IlyaAyupov/injector/docs.pdf

# Инжекторная система впрыска для мотоцикла Урал

Аюпов И.Я. (https://github.com/IlyaAyupov)

лето 2020

1

## 1 Металл

Установка воздушной заслонки с датчиком положения дроссельной заслонки и регулятором холостого хода (от ВАЗ 2110).

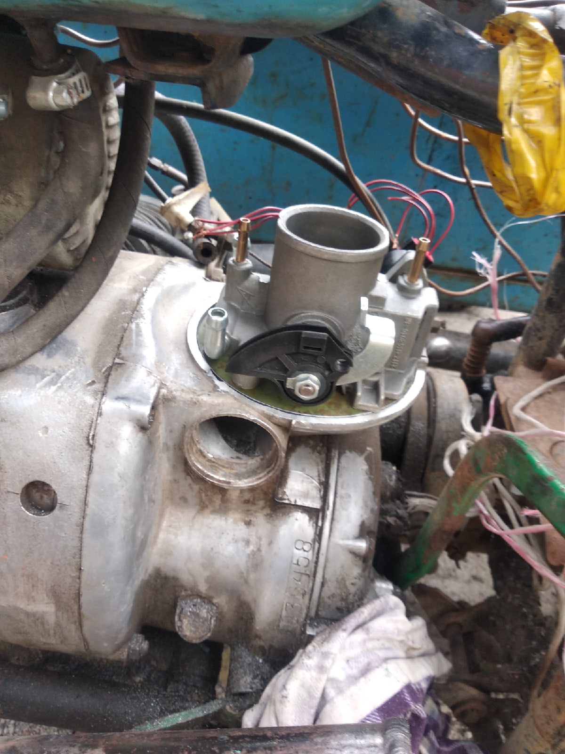
[picture p1: figure]

2

Изготовление посадочного места для форсунок.

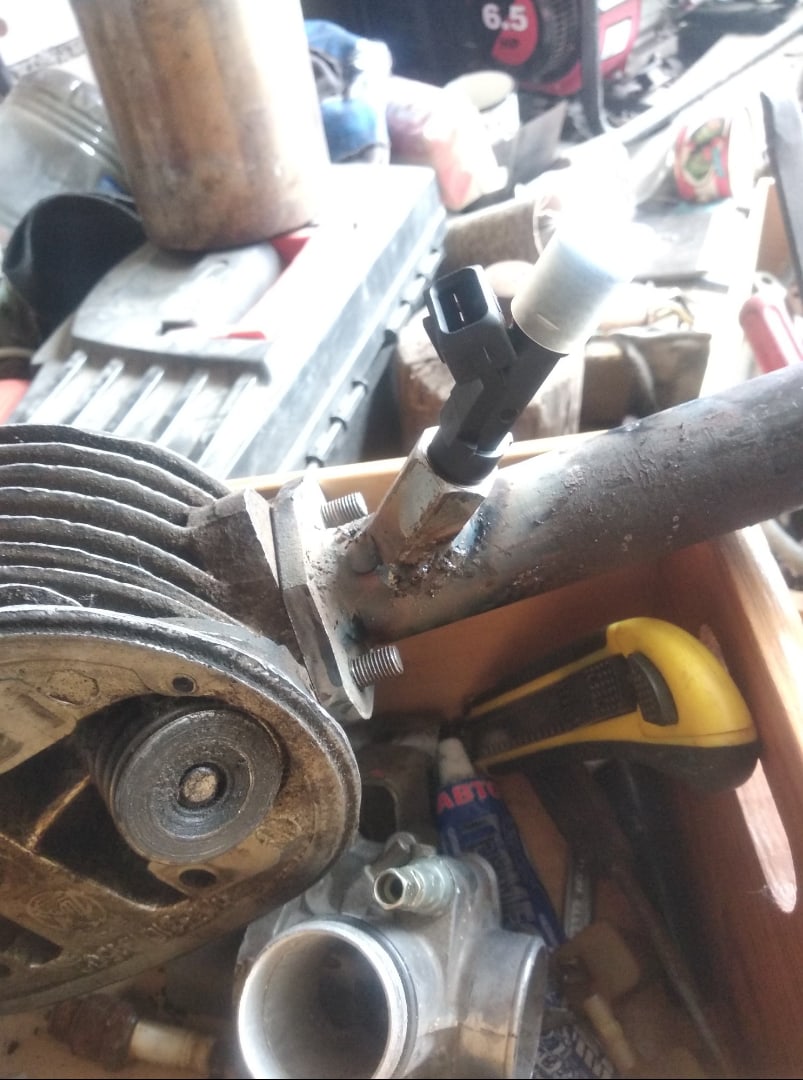
[picture p2: figure]

3

Изготовление и установка впускной системы.

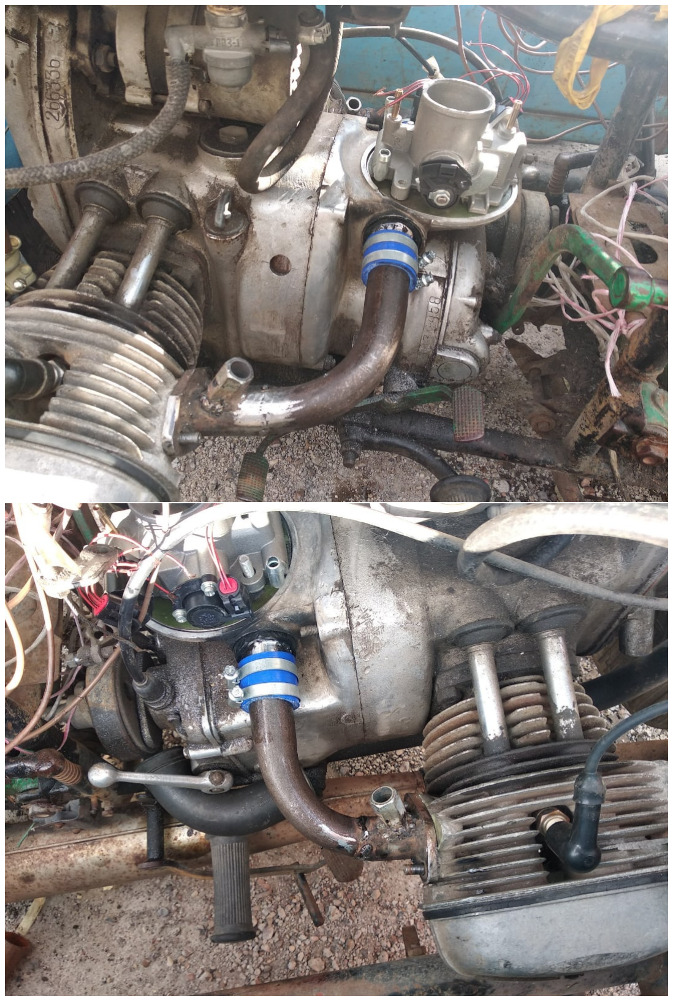
[picture p3: figure]

4

Сборка топливной системы (регулятор давления топлива и топливный насос).

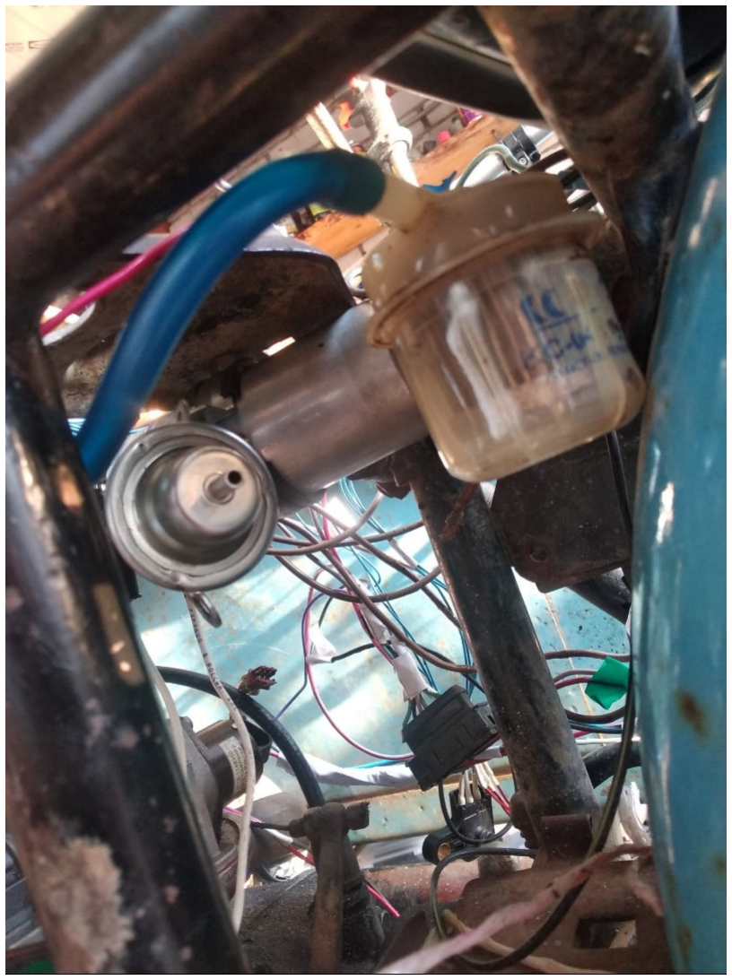
[picture p4: figure]

5

Изготовление и установка задающей шторки.

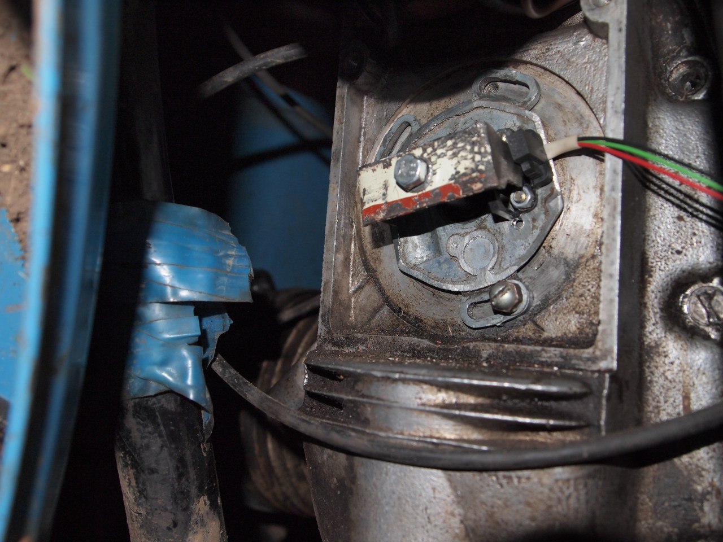
[picture p5: figure]

## 2 Блок управления

Блок управления основан на микроконтроллере STM32F103C8T6, который обрабатывает данные с аналоговых датчиков (датчик абсолютного давления, датчик положения дроссельной заслонки, датчик напряжения бортовой сети) и цифрового датчика положения коленчатого вала.
ЭБУ осуществляет управление форсунками, зажиганием и регулятором холостого хода.

## 3 Результаты

По результатам пробных выездов было замечено отсутствие провалов при резком открытии газа, улучшение динамики, увеличение крутящего момента двигателя и улучшение стабильности работы и запуска двигателя.

6
