IlyaAyupov/injector/hardware/PCB.pdf

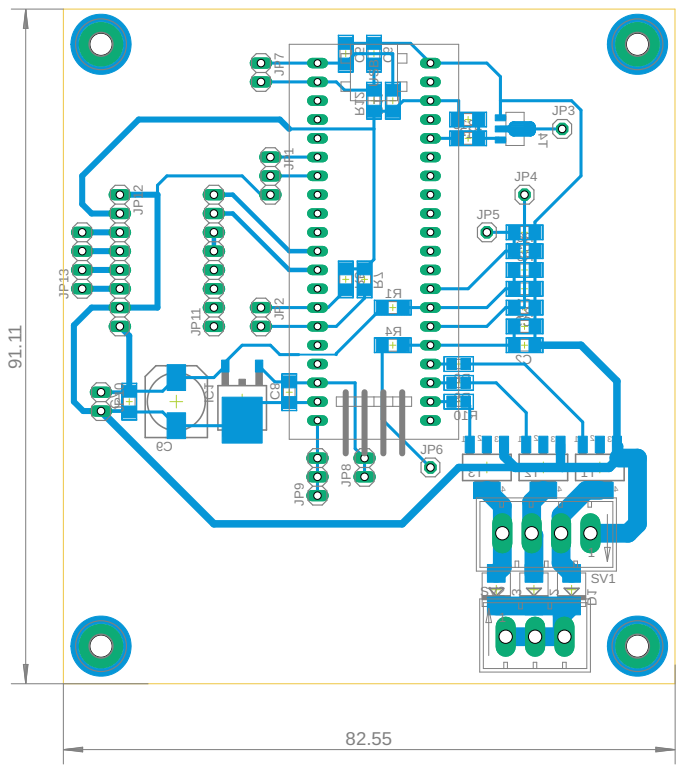
[picture p6: page 1]
