IlyaAyupov/injector/hardware/schematic.pdf

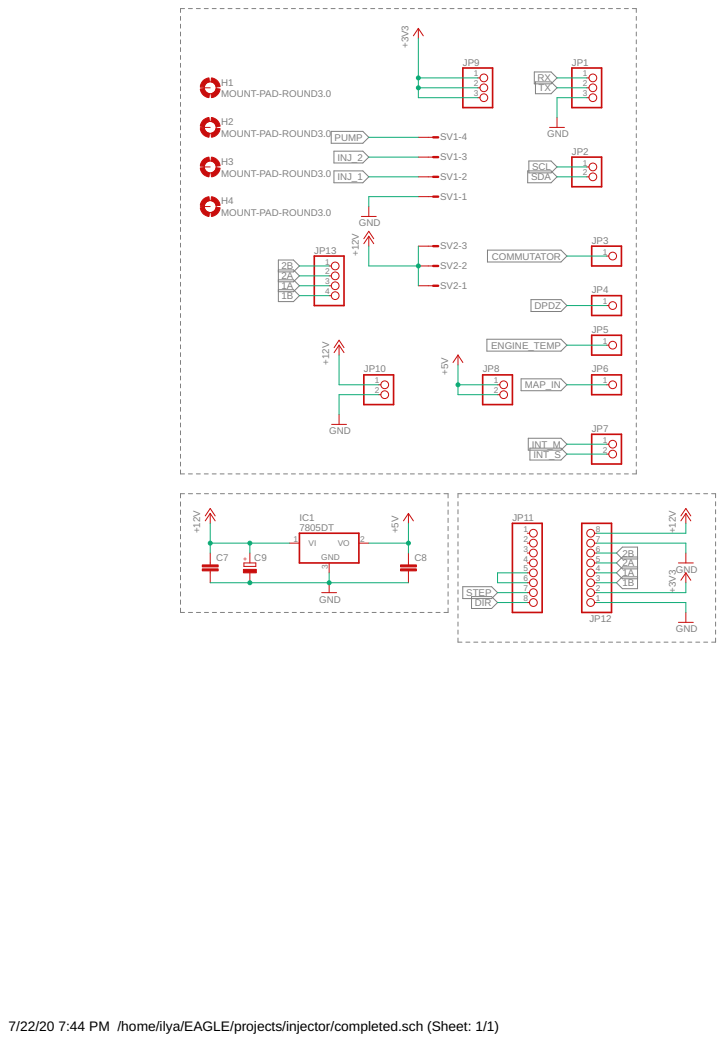
[picture p7: page 1]

7/22/20 7:44 PM /home/ilya/EAGLE/projects/injector/completed.sch (Sheet: 1/1)

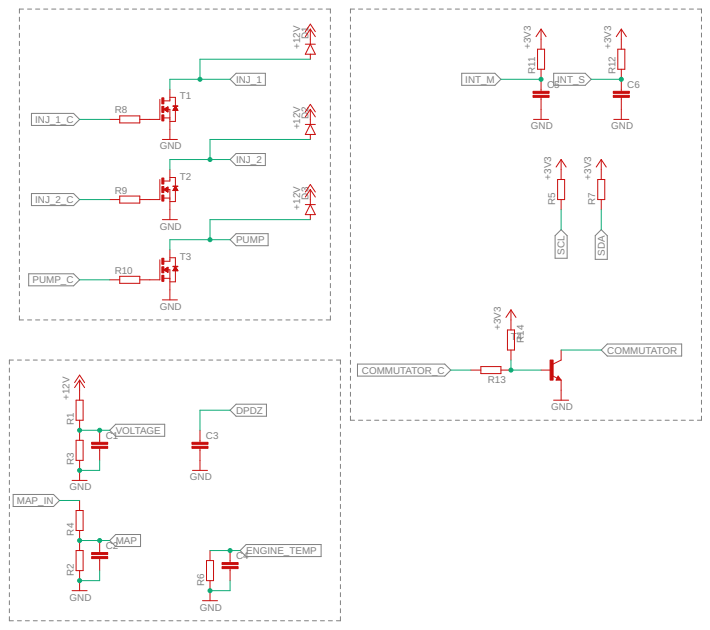
[picture p8: page 2]

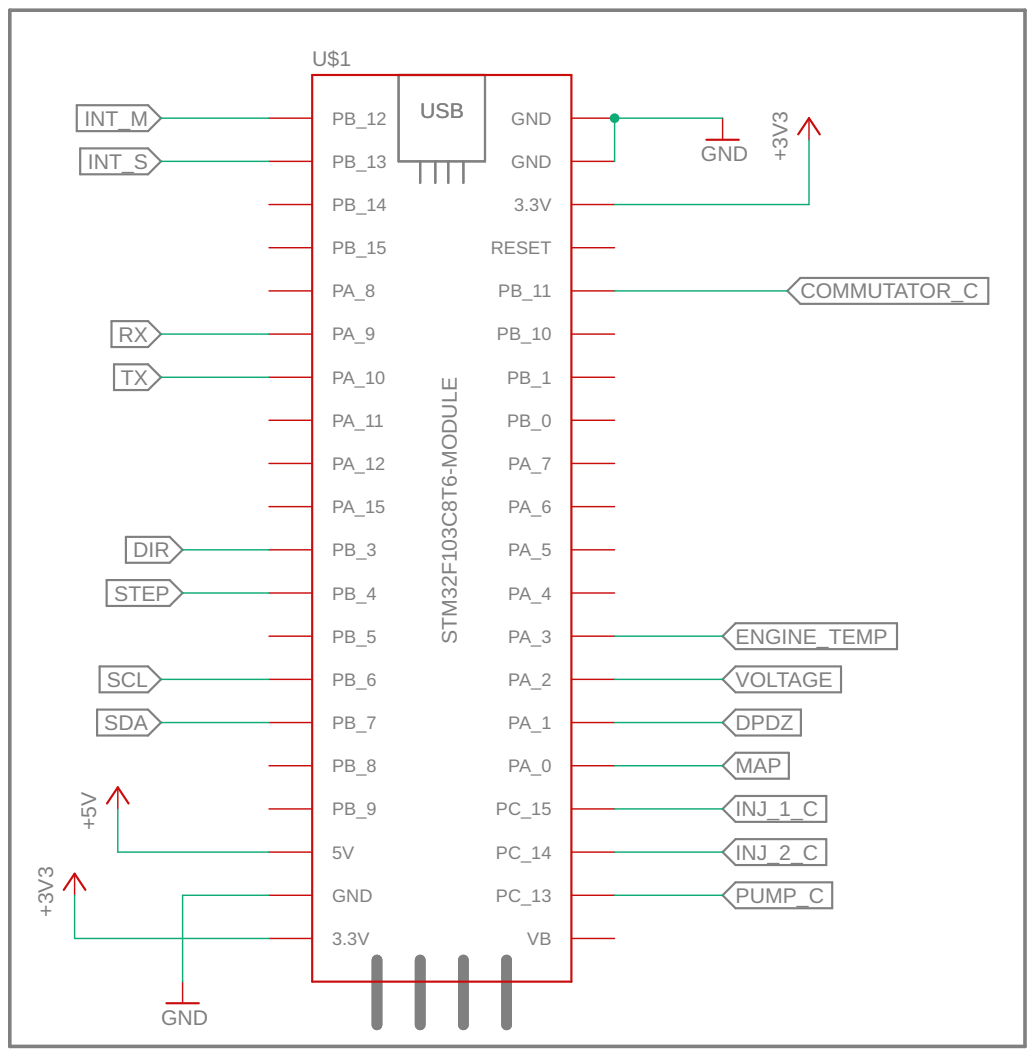
[picture p9: page 3]
