IlyaAyupov/injector/hardware/control_board.brd

## EAGLE design hardware/control_board.brd (2020-09-04)

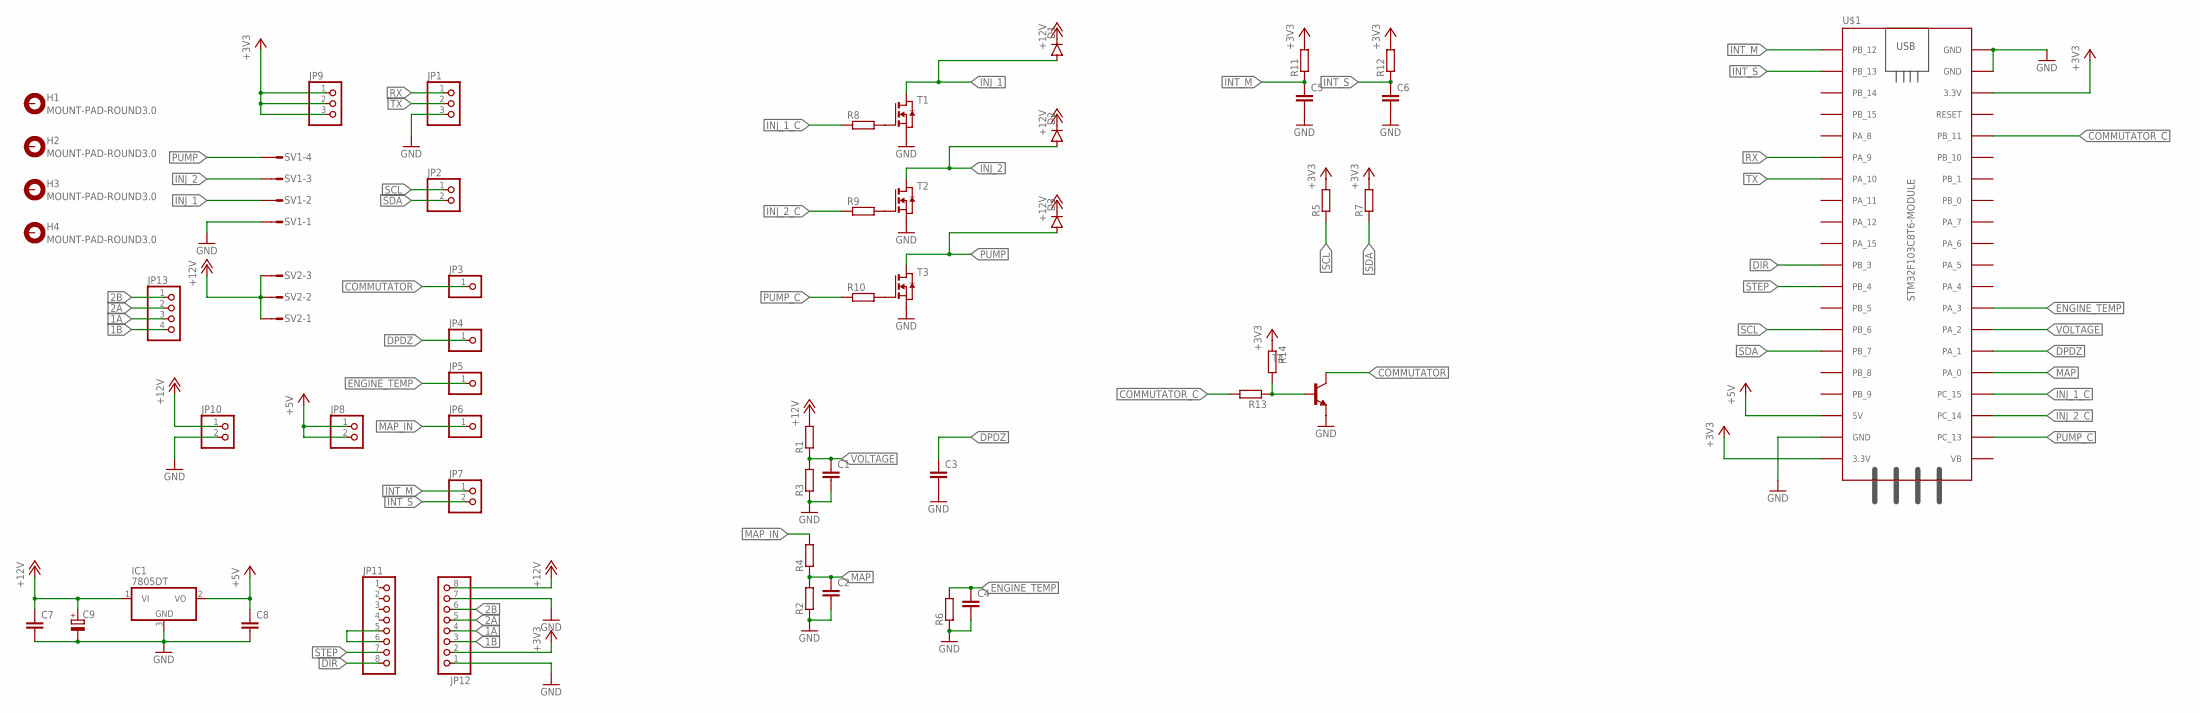
[picture p10: schematic control_board.sch]

Parts:
C1, C2, C3, C4, C5, C6, C7, C8: C-EUC1206; C1206
C9: CPOL-EU140CLH-0810; 140CLH-0810
D1, D2, D3: DIODE-SMB; SMB
H1, H2, H3, H4: MOUNT-PAD-ROUND3.0; 3,0-PAD
IC1: 7805DT; TO252
JP1, JP9: PINHD-1X3; 1X03
JP2, JP7, JP8, JP10: PINHD-1X2; 1X02
JP3, JP4, JP5, JP6: PINHD-1X1; 1X01
JP11, JP12: PINHD-1X8; 1X08
JP13: PINHD-1X4; 1X04
R1, R2, R3, R4, R5, R6, R7, R11, R12, R13, R14: R-EU_R1206; R1206
R8, R9, R10: R-EU_R0805; R0805
SV1: MT6-4
SV2: MT6-3
T1, T2, T3: NMOSSOT223; SOT223
T4: BCX54-NPN-SOT89-BCE; SOT89-BCE
U$1: STM32F103C8T6-MODULE

Connections:
1A: JP12.4, JP13.3
1B: JP12.3, JP13.4
2A: JP12.5, JP13.2
2B: JP12.6, JP13.1
+3V3: JP9.1, JP9.2, JP9.3, JP12.2, R5.2, R7.2, R11.2, R12.2, R14.1, U$1.3.3V_1 (3.3V), U$1.3.3V_2 (3.3V)
+5V: C8.1, IC1.2 (VO), JP8.1, JP8.2, U$1.5V
+12V: C7.1, C9.+, D1.C, D2.C, D3.C, IC1.1 (VI), JP10.1, JP12.8, R1.2, SV2.1, SV2.2, SV2.3
COMMUTATOR: JP3.1, T4.C
COMMUTATOR_C: R13.2, U$1.PB_11
DIR: JP11.8, U$1.PB_3
DPDZ: C3.1, JP4.1, U$1.PA_1
ENGINE_TEMP: C4.1, JP5.1, R6.2, U$1.PA_3
GND: C1.2, C2.2, C3.2, C4.2, C5.2, C6.2, C7.2, C8.2, C9.-, IC1.3 (GND), JP1.3, JP10.2, JP12.1, JP12.7, R2.1, R3.1, R6.1, SV1.1, T1.3 (S), T2.3 (S), T3.3 (S), T4.E, U$1.GND_1 (GND), U$1.GND_2 (GND), U$1.GND_3 (GND)
INJ_1: D1.A, SV1.2, T1.2 (D), T1.4 (D)
INJ_1_C: R8.1, U$1.PC_15
INJ_2: D2.A, SV1.3, T2.2 (D), T2.4 (D)
INJ_2_C: R9.1, U$1.PC_14
INT_M: C5.1, JP7.1, R11.1, U$1.PB_12
INT_S: C6.1, JP7.2, R12.1, U$1.PB_13
MAP: C2.1, R2.2, R4.1, U$1.PA_0
MAP_IN: JP6.1, R4.2
unnamed: JP11.5, JP11.6
unnamed: R13.1, R14.2, T4.B
unnamed: R8.2, T1.1 (G)
unnamed: R9.2, T2.1 (G)
unnamed: R10.2, T3.1 (G)
PUMP: D3.A, SV1.4, T3.2 (D), T3.4 (D)
PUMP_C: R10.1, U$1.PC_13
RX: JP1.1, U$1.PA_9
SCL: JP2.1, R5.1, U$1.PB_6
SDA: JP2.2, R7.1, U$1.PB_7
STEP: JP11.7, U$1.PB_4
TX: JP1.2, U$1.PA_10
VOLTAGE: C1.1, R1.1, R3.2, U$1.PA_2

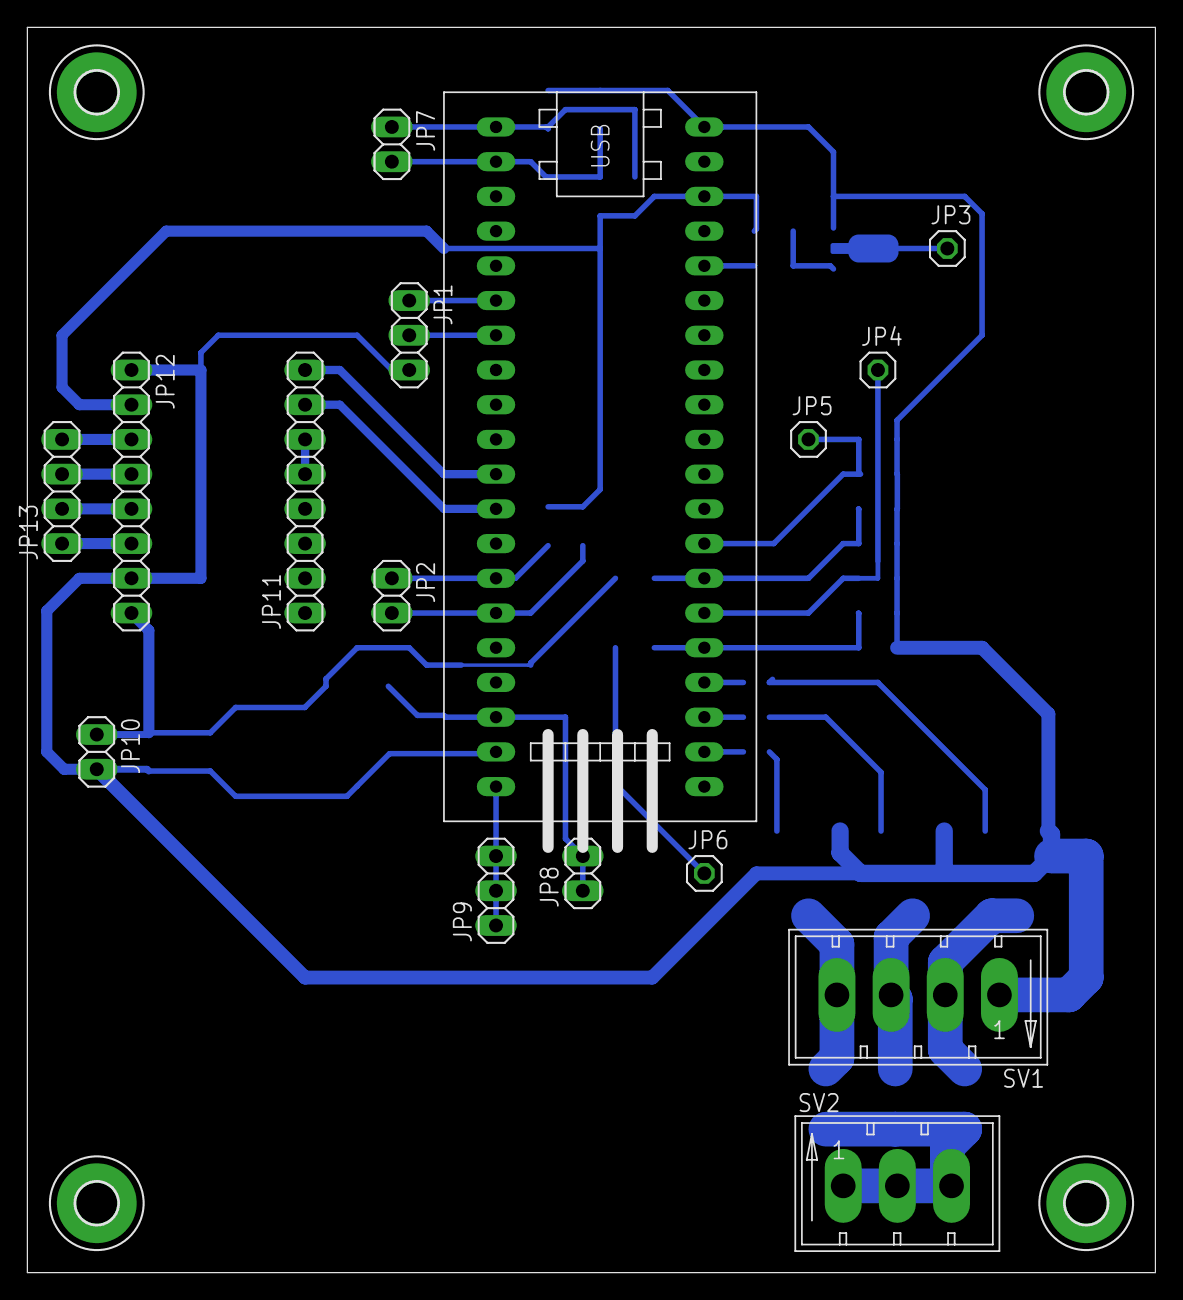
[picture p11: board control_board.brd from above]

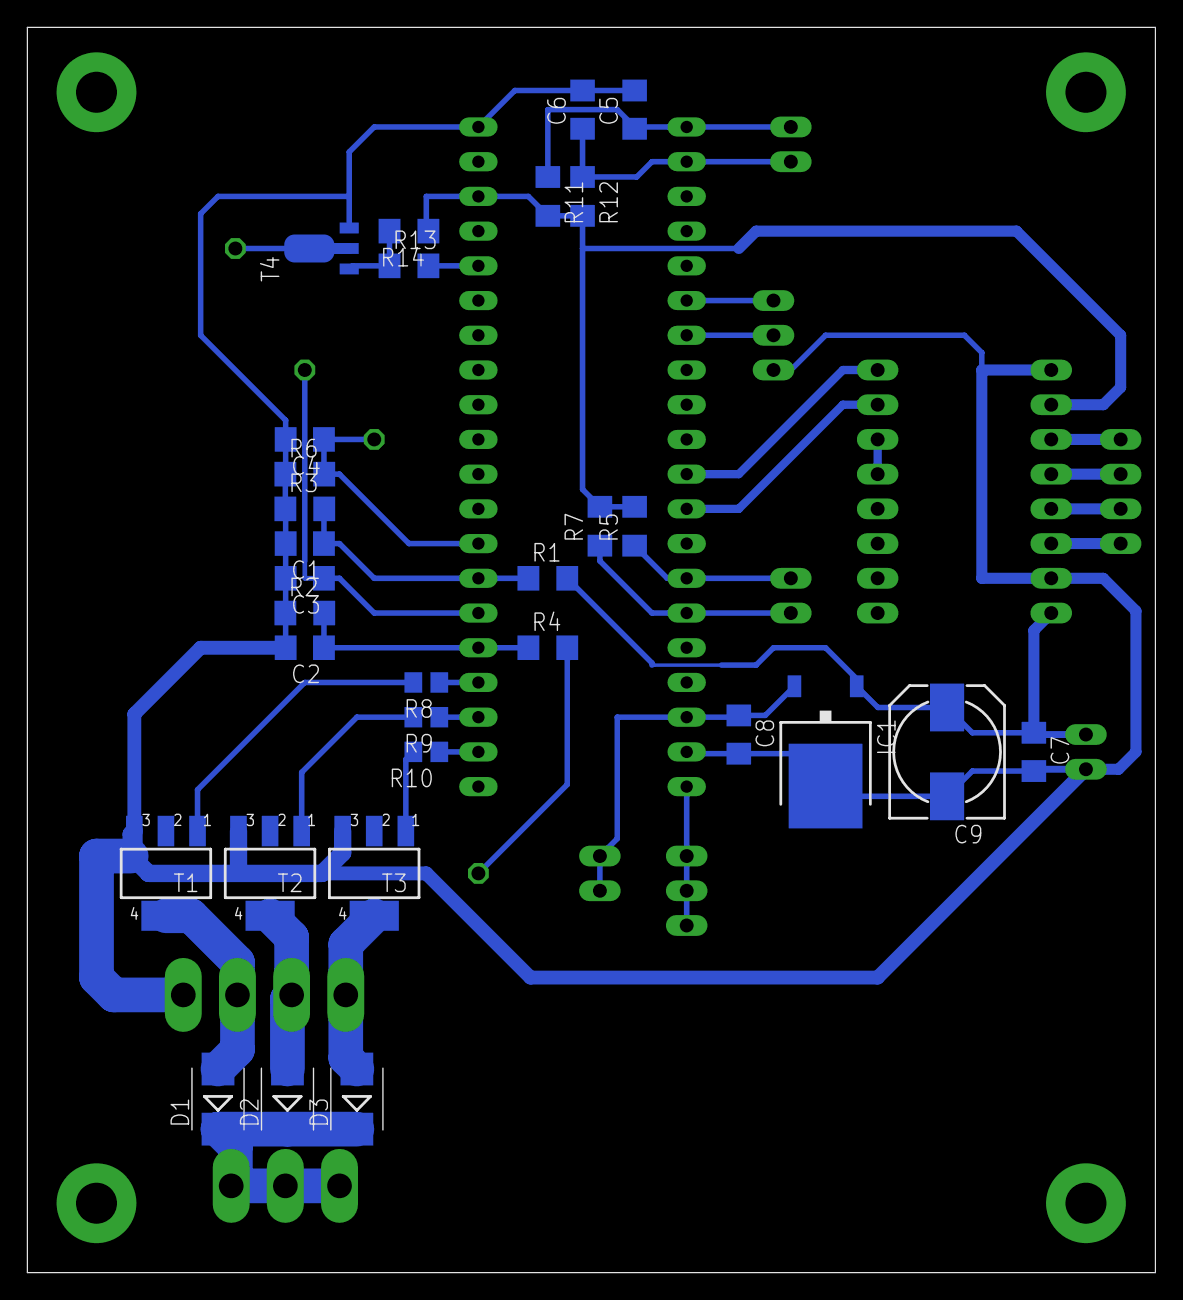
[picture p12: board control_board.brd from below]

Board: 2 copper layers, 82.5 x 91.1 mm, 51 parts (31 on the bottom side), 34 nets.
