IlyaAyupov/injector/code/stm/Src/main.c

#include "main.h"
#define DPDZ_MIN 447
#define DPDZ_MAX 3500
#define THROTTLE_LIMIT 3
ADC_HandleTypeDef hadc1;
DMA_HandleTypeDef hdma_adc1;

TIM_HandleTypeDef htim3;

UART_HandleTypeDef huart1;

#define RXX_DELAY 2

void SystemClock_Config(void);
static void MX_GPIO_Init(void);
static void MX_DMA_Init(void);
static void MX_ADC1_Init(void);
static void MX_TIM3_Init(void);
static void MX_USART1_UART_Init(void);
uint8_t injLag[]={11,11,11,11,11,11,11,11,11,11,11,9,8,7,6,5};
uint16_t time=0;
uint16_t getLag(float voltage){
	uint8_t l=(int)voltage;
	return injLag[l]+(injLag[l+1]-injLag[l])*(voltage-l);
}
void calculation(){
	if(engine.temporary.timing==0)engine.RPM=0;
	else engine.RPM=(6000000*15)/(engine.temporary.timing*18);
	engine.voltage=(adcData.voltage*537.9)/135168.0;
	engine.pressure=37500.0+30.4138*adcData.map;
	engine.injTime=engine.RPM>400?((uint16_t)(6.51*engine.pressure*engine.Kc/(engine.temperature*engine.AFR))+getLag(engine.voltage)):110;
	engine.throttle=(adcData.DPDZ-DPDZ_MIN)*100.0/(DPDZ_MAX-DPDZ_MIN);
}
void move(uint8_t step,uint8_t dir){
	//engine.RXX+=dir?(-step):step;

	HAL_GPIO_WritePin(GPIOB, GPIO_PIN_3, dir);
	for(int i=0;i<step;i++){
		  HAL_GPIO_WritePin(GPIOB, GPIO_PIN_4, 1);
		  HAL_Delay(RXX_DELAY);

		  HAL_GPIO_WritePin(GPIOB, GPIO_PIN_4, 0);
		  HAL_Delay(RXX_DELAY);
	  }
}
void init(){
	engine.Kc=0.18;
	engine.AFR=14.7;
	engine.temperature=298;
	engine.RPM_XX=500;
}

int main(void)
{
  HAL_Init();
  SystemClock_Config();
  MX_GPIO_Init();
  MX_DMA_Init();
  MX_ADC1_Init();
  MX_TIM3_Init();
  MX_USART1_UART_Init();
  HAL_TIM_Base_Start_IT(&htim3);
  char buffer[100];
  HAL_GPIO_WritePin(GPIOC, GPIO_PIN_14,0);
  HAL_GPIO_WritePin(GPIOC, GPIO_PIN_15,0);
  HAL_GPIO_WritePin(GPIOC, GPIO_PIN_13,1);
  HAL_GPIO_WritePin(GPIOB, GPIO_PIN_11,0);
  RCC->APB1ENR |= RCC_APB1ENR_TIM2EN;
  HAL_ADC_Start_DMA(&hadc1, (uint32_t*)&adcData, 3);
  HAL_Delay(10);
  init();
  while (1)
  {
    if(engine.RPM==0){
		  engine.Kc=0.3;
		  time=0;
	  }
	  time++;
	  if(time>50){
		  engine.Kc=0.2;
	  }
	  calculation();
	  move(abs(engine.RPM-engine.RPM_XX)/100,engine.RPM>700?1:0);
	  sprintf(buffer,"A\n\r%f\n\r%f\n\r%d\n\r%d\n\r%f\n\r%d\n\r",engine.pressure,engine.voltage,engine.RPM,engine.injTime,engine.throttle,engine.RXX);
	  HAL_ADC_Start_DMA(&hadc1, (uint32_t*)&adcData, 3);
	  HAL_UART_Transmit(&huart1,buffer,strlen(buffer),1000);
	  HAL_Delay(200);

  }
}
void SystemClock_Config(void)
{
  RCC_OscInitTypeDef RCC_OscInitStruct = {0};
  RCC_ClkInitTypeDef RCC_ClkInitStruct = {0};
  RCC_PeriphCLKInitTypeDef PeriphClkInit = {0};
  RCC_OscInitStruct.OscillatorType = RCC_OSCILLATORTYPE_HSE;
  RCC_OscInitStruct.HSEState = RCC_HSE_ON;
  RCC_OscInitStruct.HSEPredivValue = RCC_HSE_PREDIV_DIV1;
  RCC_OscInitStruct.HSIState = RCC_HSI_ON;
  RCC_OscInitStruct.PLL.PLLState = RCC_PLL_ON;
  RCC_OscInitStruct.PLL.PLLSource = RCC_PLLSOURCE_HSE;
  RCC_OscInitStruct.PLL.PLLMUL = RCC_PLL_MUL9;
  if (HAL_RCC_OscConfig(&RCC_OscInitStruct) != HAL_OK)
  {
    Error_Handler();
  }
  RCC_ClkInitStruct.ClockType = RCC_CLOCKTYPE_HCLK|RCC_CLOCKTYPE_SYSCLK
                              |RCC_CLOCKTYPE_PCLK1|RCC_CLOCKTYPE_PCLK2;
  RCC_ClkInitStruct.SYSCLKSource = RCC_SYSCLKSOURCE_PLLCLK;
  RCC_ClkInitStruct.AHBCLKDivider = RCC_SYSCLK_DIV1;
  RCC_ClkInitStruct.APB1CLKDivider = RCC_HCLK_DIV2;
  RCC_ClkInitStruct.APB2CLKDivider = RCC_HCLK_DIV1;

  if (HAL_RCC_ClockConfig(&RCC_ClkInitStruct, FLASH_LATENCY_2) != HAL_OK)
  {
    Error_Handler();
  }
  PeriphClkInit.PeriphClockSelection = RCC_PERIPHCLK_ADC;
  PeriphClkInit.AdcClockSelection = RCC_ADCPCLK2_DIV6;
  if (HAL_RCCEx_PeriphCLKConfig(&PeriphClkInit) != HAL_OK)
  {
    Error_Handler();
  }
}
static void MX_ADC1_Init(void)
{

  ADC_ChannelConfTypeDef sConfig = {0};
  hadc1.Instance = ADC1;
  hadc1.Init.ScanConvMode = ADC_SCAN_ENABLE;
  hadc1.Init.ContinuousConvMode = DISABLE;
  hadc1.Init.DiscontinuousConvMode = DISABLE;
  hadc1.Init.ExternalTrigConv = ADC_SOFTWARE_START;
  hadc1.Init.DataAlign = ADC_DATAALIGN_RIGHT;
  hadc1.Init.NbrOfConversion = 3;
  if (HAL_ADC_Init(&hadc1) != HAL_OK)
  {
    Error_Handler();
  }
  sConfig.Channel = ADC_CHANNEL_0;
  sConfig.Rank = ADC_REGULAR_RANK_1;
  sConfig.SamplingTime = ADC_SAMPLETIME_1CYCLE_5;
  if (HAL_ADC_ConfigChannel(&hadc1, &sConfig) != HAL_OK)
  {
    Error_Handler();
  }
  sConfig.Channel = ADC_CHANNEL_1;
  sConfig.Rank = ADC_REGULAR_RANK_2;
  if (HAL_ADC_ConfigChannel(&hadc1, &sConfig) != HAL_OK)
  {
    Error_Handler();
  }
  sConfig.Channel = ADC_CHANNEL_2;
  sConfig.Rank = ADC_REGULAR_RANK_3;
  if (HAL_ADC_ConfigChannel(&hadc1, &sConfig) != HAL_OK)
  {
    Error_Handler();
  }

}

static void MX_TIM3_Init(void)
{
  TIM_ClockConfigTypeDef sClockSourceConfig = {0};
  TIM_MasterConfigTypeDef sMasterConfig = {0};
  htim3.Instance = TIM3;
  htim3.Init.Prescaler = 719;
  htim3.Init.CounterMode = TIM_COUNTERMODE_UP;
  htim3.Init.Period = 49999;
  htim3.Init.ClockDivision = TIM_CLOCKDIVISION_DIV1;
  htim3.Init.AutoReloadPreload = TIM_AUTORELOAD_PRELOAD_DISABLE;
  if (HAL_TIM_Base_Init(&htim3) != HAL_OK)
  {
    Error_Handler();
  }
  sClockSourceConfig.ClockSource = TIM_CLOCKSOURCE_INTERNAL;
  if (HAL_TIM_ConfigClockSource(&htim3, &sClockSourceConfig) != HAL_OK)
  {
    Error_Handler();
  }
  sMasterConfig.MasterOutputTrigger = TIM_TRGO_RESET;
  sMasterConfig.MasterSlaveMode = TIM_MASTERSLAVEMODE_DISABLE;
  if (HAL_TIMEx_MasterConfigSynchronization(&htim3, &sMasterConfig) != HAL_OK)
  {
    Error_Handler();
  }

}

static void MX_USART1_UART_Init(void)
{
  huart1.Instance = USART1;
  huart1.Init.BaudRate = 115200;
  huart1.Init.WordLength = UART_WORDLENGTH_8B;
  huart1.Init.StopBits = UART_STOPBITS_1;
  huart1.Init.Parity = UART_PARITY_NONE;
  huart1.Init.Mode = UART_MODE_TX_RX;
  huart1.Init.HwFlowCtl = UART_HWCONTROL_NONE;
  huart1.Init.OverSampling = UART_OVERSAMPLING_16;
  if (HAL_UART_Init(&huart1) != HAL_OK)
  {
    Error_Handler();
  }

}

static void MX_DMA_Init(void) 
{

  __HAL_RCC_DMA1_CLK_ENABLE();
  HAL_NVIC_SetPriority(DMA1_Channel1_IRQn, 0, 0);
  HAL_NVIC_EnableIRQ(DMA1_Channel1_IRQn);

}

static void MX_GPIO_Init(void)
{
  GPIO_InitTypeDef GPIO_InitStruct = {0};
  __HAL_RCC_GPIOC_CLK_ENABLE();
  __HAL_RCC_GPIOD_CLK_ENABLE();
  __HAL_RCC_GPIOA_CLK_ENABLE();
  __HAL_RCC_GPIOB_CLK_ENABLE();

  HAL_GPIO_WritePin(GPIOC, GPIO_PIN_13|GPIO_PIN_14|GPIO_PIN_15, GPIO_PIN_RESET);
  HAL_GPIO_WritePin(GPIOB, GPIO_PIN_11|GPIO_PIN_3|GPIO_PIN_4, GPIO_PIN_RESET);
  GPIO_InitStruct.Pin = GPIO_PIN_13|GPIO_PIN_14|GPIO_PIN_15;
  GPIO_InitStruct.Mode = GPIO_MODE_OUTPUT_PP;
  GPIO_InitStruct.Pull = GPIO_NOPULL;
  GPIO_InitStruct.Speed = GPIO_SPEED_FREQ_LOW;
  HAL_GPIO_Init(GPIOC, &GPIO_InitStruct);
  GPIO_InitStruct.Pin = GPIO_PIN_11|GPIO_PIN_3|GPIO_PIN_4;
  GPIO_InitStruct.Mode = GPIO_MODE_OUTPUT_PP;
  GPIO_InitStruct.Pull = GPIO_NOPULL;
  GPIO_InitStruct.Speed = GPIO_SPEED_FREQ_LOW;
  HAL_GPIO_Init(GPIOB, &GPIO_InitStruct);
  GPIO_InitStruct.Pin = GPIO_PIN_12;
  GPIO_InitStruct.Mode = GPIO_MODE_IT_RISING_FALLING;
  GPIO_InitStruct.Pull = GPIO_NOPULL;
  HAL_GPIO_Init(GPIOB, &GPIO_InitStruct);
  HAL_NVIC_SetPriority(EXTI15_10_IRQn, 0, 0);
  HAL_NVIC_EnableIRQ(EXTI15_10_IRQn);

}

void Error_Handler(void)
{
}
